HexOhmLabs/ESP-Siesta-Clock-with-Matrix-Display/README.md

# ESP Siesta Clock with Matrix Display

**A clever, super-dark clock that respects your sleep.**

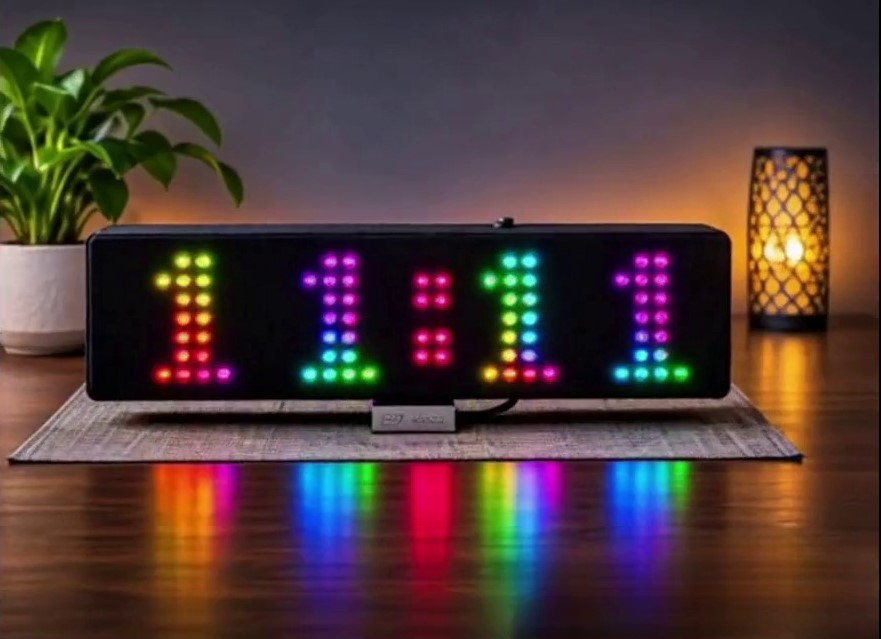
[picture p1: media/ESP_Siesta_Clock_Hero_624.jpg]
ESP Siesta Clock


**2026 by HexOhm**

## Final firmware

`Siesta_WiFi_Clock_HOLIDAYS_WEEKENDS_ANIMATED_FINAL.ino`

- Lines: **8,210**
- Bytes: **182,412**
- SHA-256: `8f3d867dc6df555c29daf55e5889b521067dd3d46866f3558864752d70b486a9`

## Color modes

Mono, Solid Color, Colorful, Funny, **Animated**, Dynamic.

Animated is placed immediately after Funny. It keeps the Funny per-pixel idea but continuously and smoothly transitions each lit LED toward independently changing colors, without a short repeating loop. Existing clock priorities and functions remain unchanged.

## Included documentation

- User Manual - English
- Εγχειρίδιο Χρήσης - Ελληνικά
- Technical Reference - English
- Τεχνική Αναφορά - Ελληνικά
- Instructables publication draft
- Canonical KiCad schematic + PNG
- `IR_Remote_Tester.ino` helper utility for identifying alternative NEC remotes

## Demonstration videos

Two short vertical promo/demo videos are included. They show the clock first in a colorful bedside presentation and then the room progressively darkening as the person goes to bed, matching the project's sleep-first theme.

- `media/ESP_Siesta_Clock_Sleep_Promo_FullHD.mp4` - 1080 x 1920, 6.5 s
- `media/ESP_Siesta_Clock_Sleep_Promo_720p.mp4` - 720 x 1280, 6.5 s
- `media/ESP_Siesta_Clock_Sleep_Promo_Preview.jpg` - preview frame

The two MP4 files contain the same sequence at different resolutions.

## As-is

This project is provided as-is.
Also in Instructables at https://www.instructables.com/Esp8266-Siesta-Clock-With-Matrix-Display/

**2026 by HexOhm**
