HexOhmLabs/ESP-Siesta-Clock-with-Matrix-Display/media/1000013960.jpg

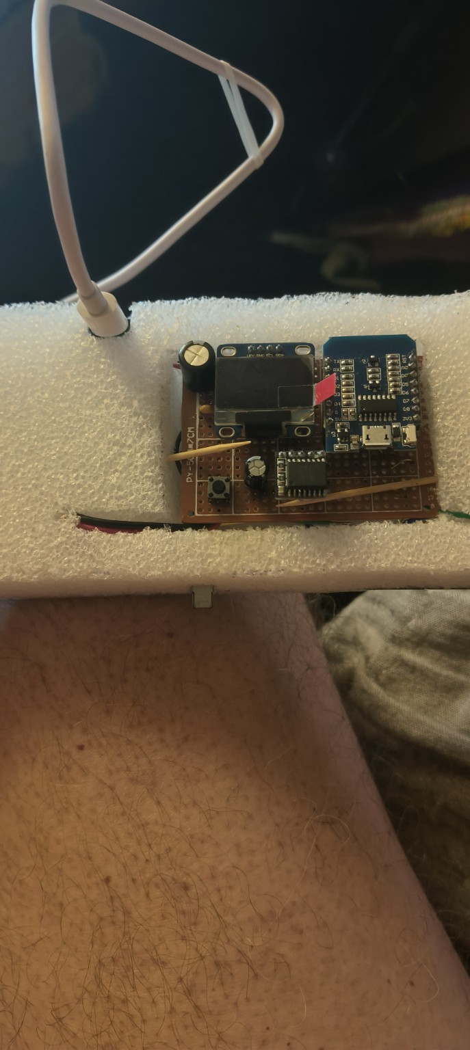
media/1000013960.jpg
