HexOhmLabs/ESP-Siesta-Clock-with-Matrix-Display/media/1000013961.jpg

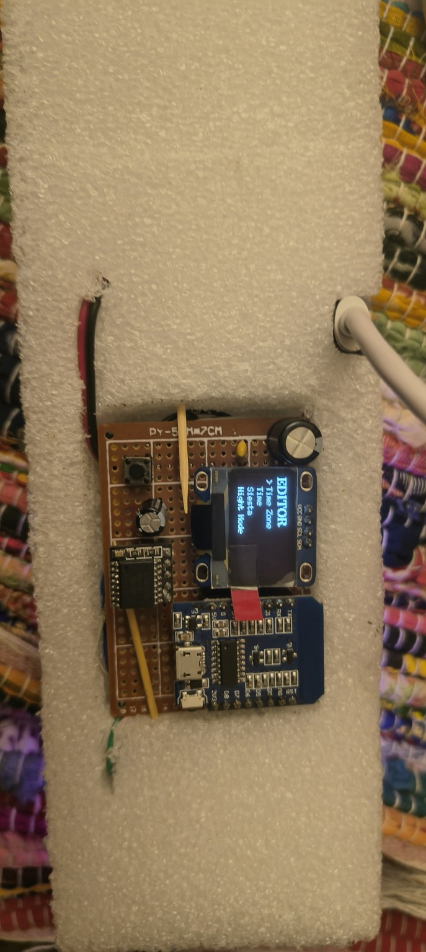
media/1000013961.jpg
