HexOhmLabs/ESP-Siesta-Clock-with-Matrix-Display/media/1000013967.jpg

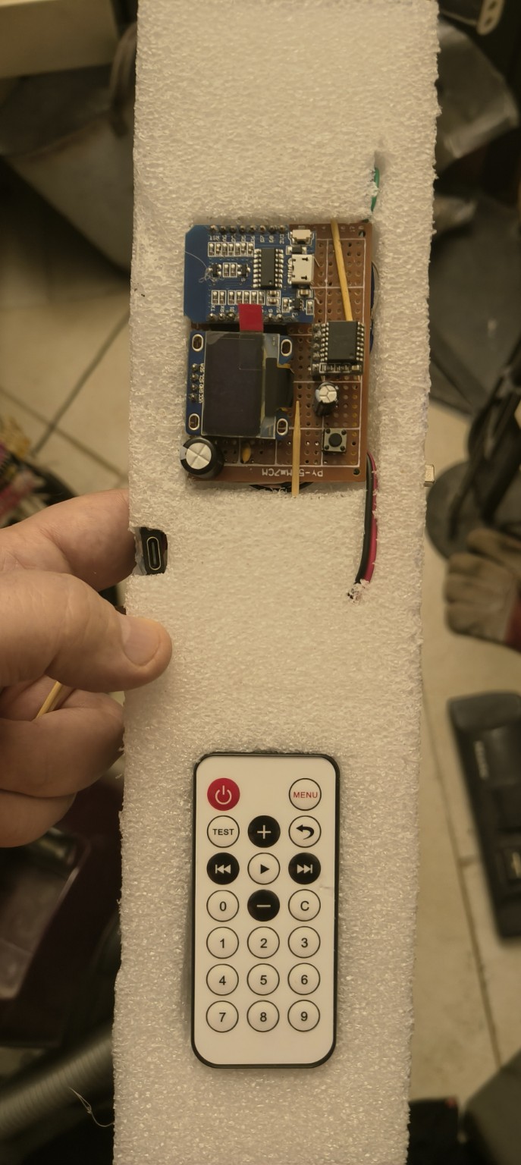
media/1000013967.jpg
