HexOhmLabs/ESP-Siesta-Clock-with-Matrix-Display/media/1000014059.jpg

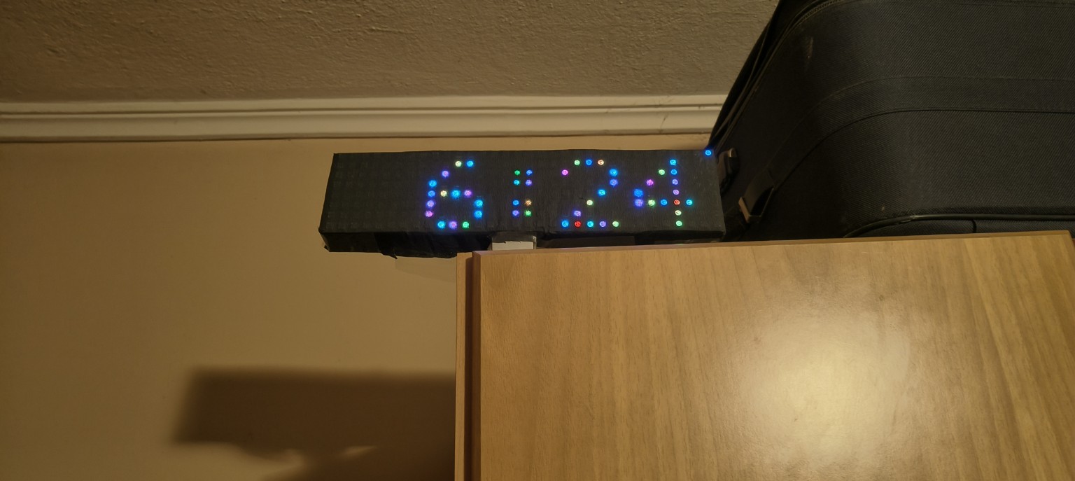
media/1000014059.jpg
