HexOhmLabs/ESP-Siesta-Clock-with-Matrix-Display/media/1000014109.jpg

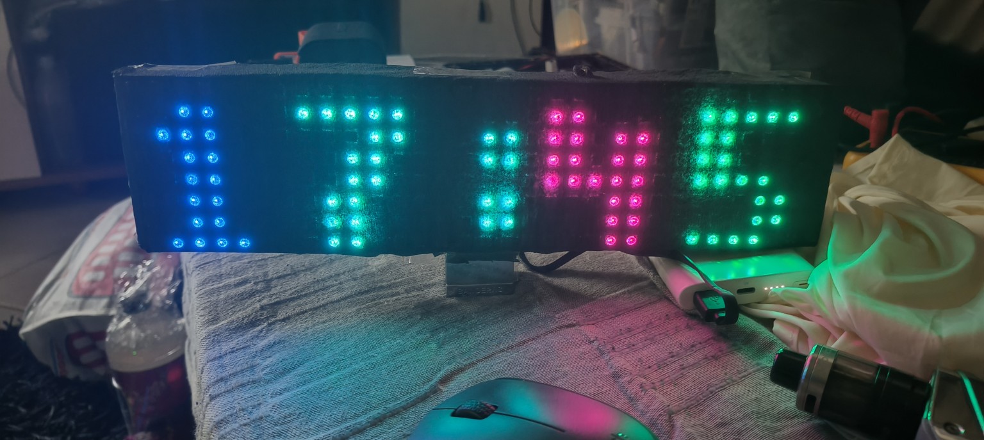
media/1000014109.jpg
