HexOhmLabs/ESP-Siesta-Clock-with-Matrix-Display/media/1000014123.jpg

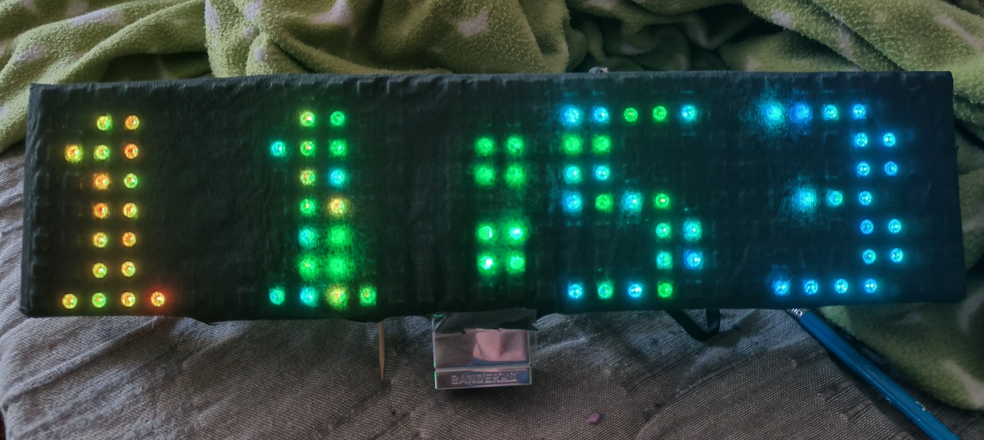
media/1000014123.jpg
