HexOhmLabs/ESP-Siesta-Clock-with-Matrix-Display/media/1000014222.jpg

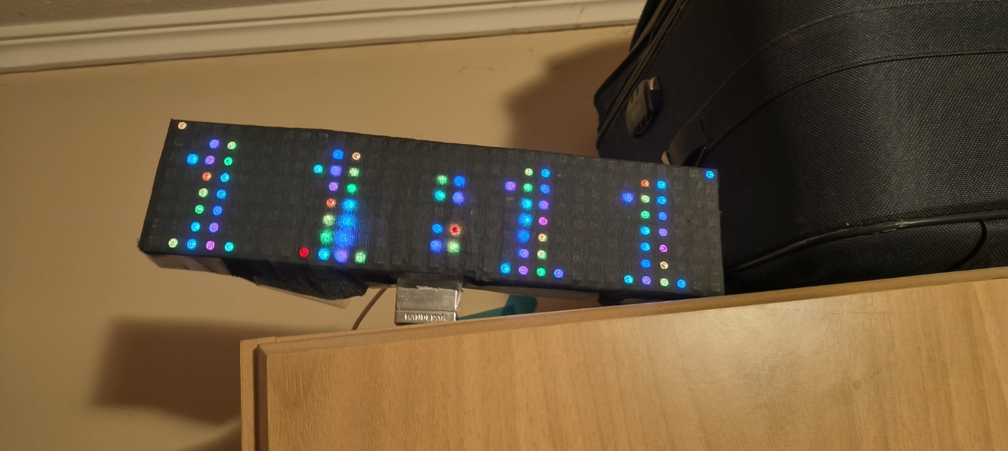
media/1000014222.jpg
