HexOhmLabs/ESP-Siesta-Clock-with-Matrix-Display/media/ESP_Siesta_Clock.png

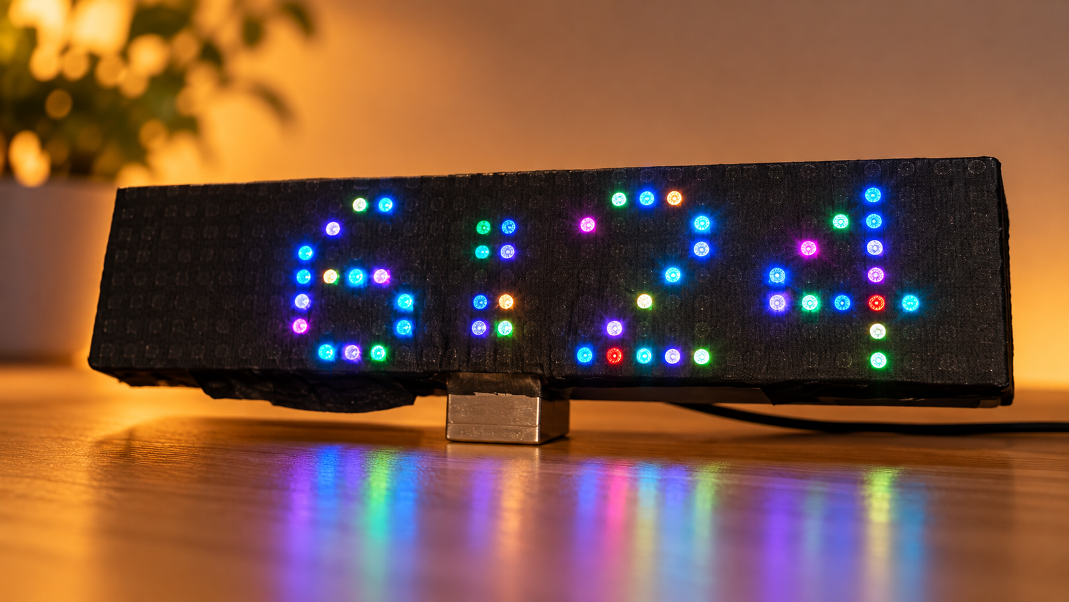
media/ESP_Siesta_Clock.png
