HexOhmLabs/ESP-Siesta-Clock-with-Matrix-Display/media/IMG20260601122547.jpg

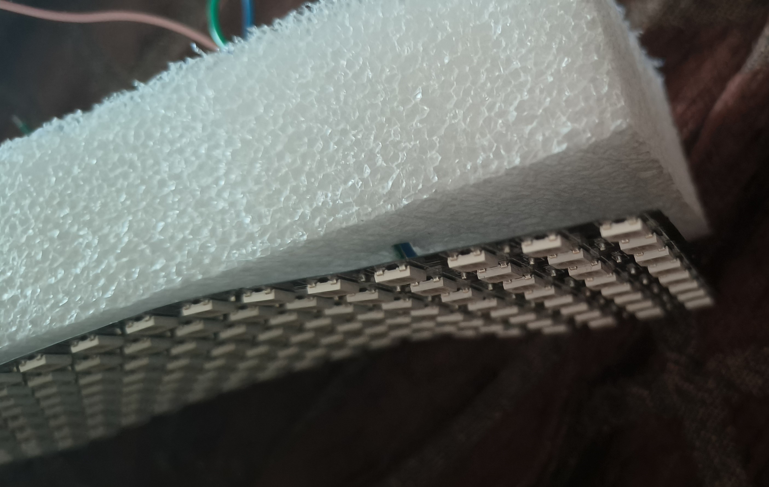
media/IMG20260601122547.jpg
