HexOhmLabs/ESP-Siesta-Clock-with-Matrix-Display/media/IR_Remote_and_Code_Detection.png

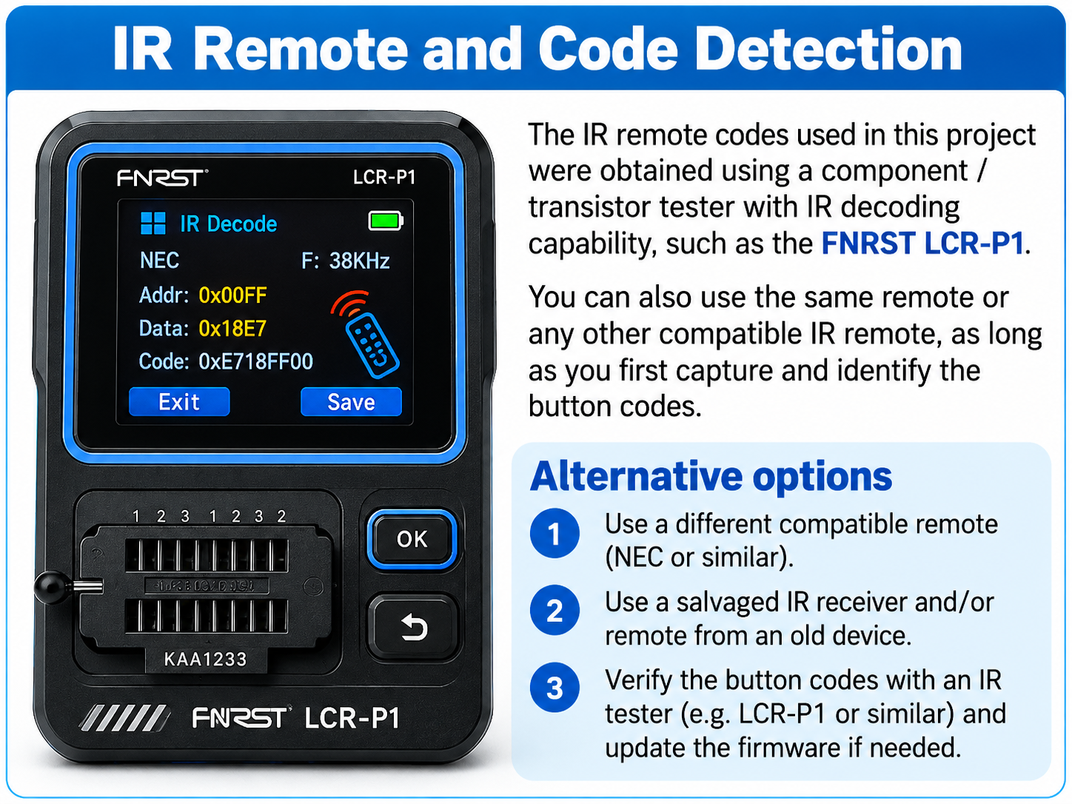
media/IR_Remote_and_Code_Detection.png
