HexOhmLabs/ESP-Siesta-Clock-with-Matrix-Display/hardware/BOM.png

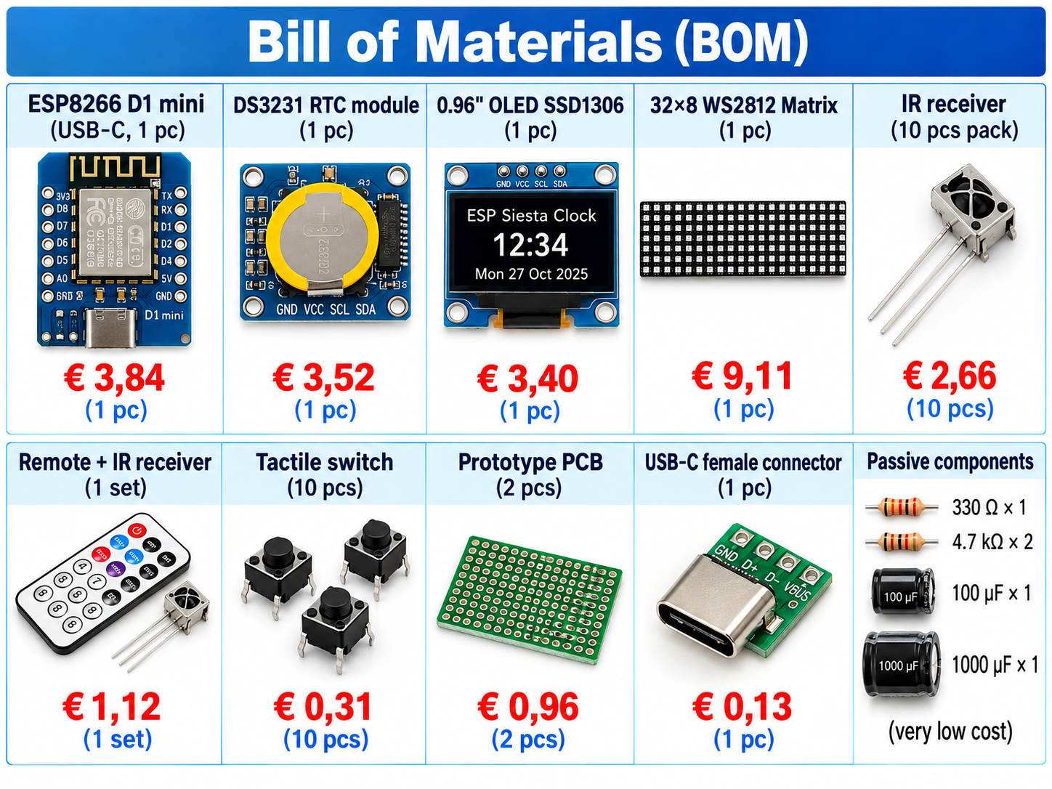
hardware/BOM.png
