HexOhmLabs/ESP-Siesta-Clock-with-Matrix-Display/RELEASE_NOTES.md

# ESP Siesta Clock - Animated Final

2026 by HexOhm

This package is synchronized with the user-tested Animated Final firmware.

## Final firmware identity

- Source: `firmware/ESP_Siesta_Clock_with_Matrix_Display.ino`
- Canonical archived source: `Siesta_WiFi_Clock_HOLIDAYS_WEEKENDS_ANIMATED_FINAL.ino`
- Lines: 8,210
- Bytes: 182,412
- SHA-256: `8f3d867dc6df555c29daf55e5889b521067dd3d46866f3558864752d70b486a9`

## Animated mode

`Animated` is placed immediately after `Funny` in the Multi Color menu. It retains the Funny per-pixel character while each lit LED smoothly transitions toward independently generated colors. The transition is continuous and does not use a short repeating animation loop.

No other clock function or parameter was intentionally changed for this feature.

## Documentation included

- English and Greek User Manuals (DOCX + PDF)
- English and Greek Technical References (DOCX + PDF)
- Instructables article (DOCX + PDF)
- README and build/upload notes
- KiCad schematic, schematic image and BOM
- IR remote tester and code-detection graphic
- Hero image

## Demonstration media

This release also includes two versions of the short sleep-themed vertical demo video:

- `media/ESP_Siesta_Clock_Sleep_Promo_FullHD.mp4` - 1080 x 1920, 6.5 s
- `media/ESP_Siesta_Clock_Sleep_Promo_720p.mp4` - 720 x 1280, 6.5 s

Both videos contain the same sequence; the two resolutions are provided for different publishing needs.
