HexOhmLabs/ESP-Siesta-Clock-with-Matrix-Display/hardware/clock.kicad_sch

## KiCad design hardware/clock.kicad_sch (2026-11-11)

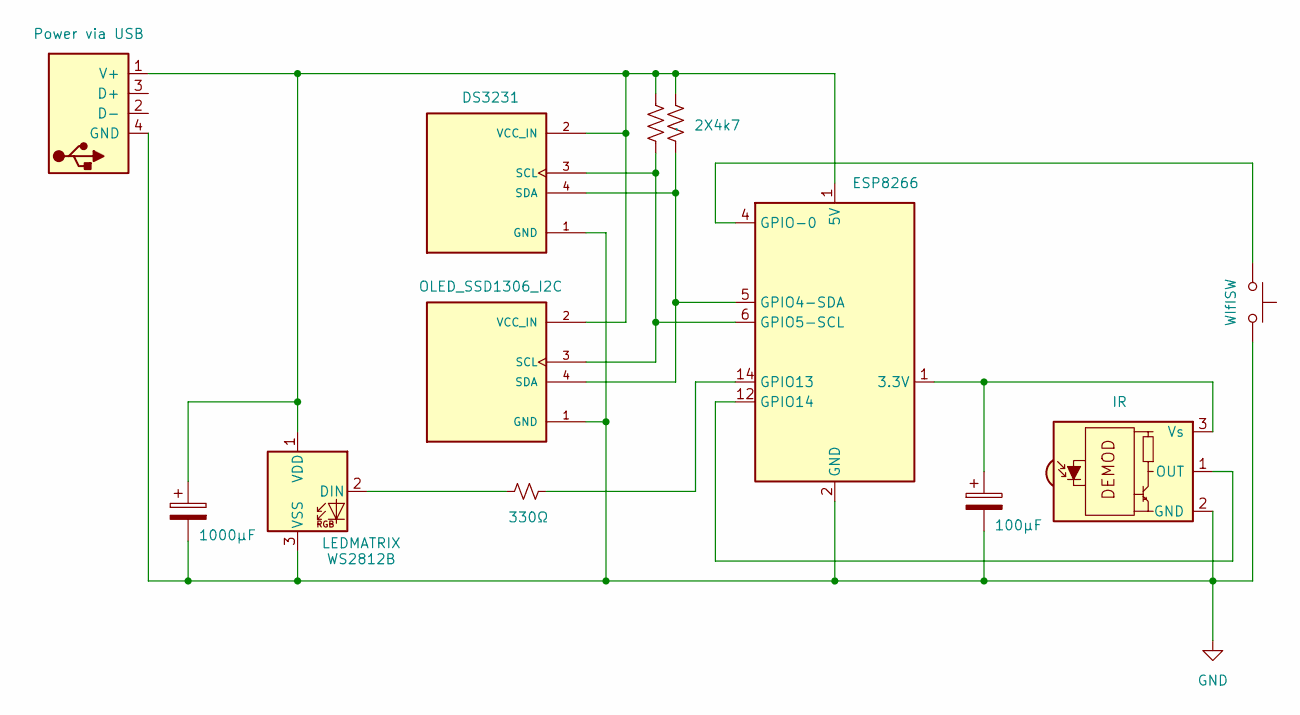
[picture p16: schematic clock.kicad_sch]

Parts:
2X4k7, .: R_US
100μF, 1000μF: C_Polarized
330Ω: R_Small_US
DS3231: DM-OLED096-636; MODULE_DM-OLED096-636; PARTREV 2018-09-10
J1: Power via USB
LEDMATRIX: WS2812B; LED_WS2812B_PLCC4_5.0x5.0mm_P3.2mm
OLED_SSD1306_I2C: DM-OLED096-636; MODULE_DM-OLED096-636; PARTREV 2018-09-10
U2: ESP8266; Olimex_MOD-WIFI-ESP8266-DEV
U3: IR; Vishay_MOLD-3Pin
WIfISW: SW_MEC_5G

Connections:
GND: 100μF.2, 1000μF.2, DS3231.1 (GND), J1.4 (GND), LEDMATRIX.3 (VSS), OLED_SSD1306_I2C.1 (GND), U2.2 (GND), U3.2 (GND), WIfISW.3 (B), WIfISW.4 (B)
unnamed: 2X4k7.2, DS3231.4 (SDA), OLED_SSD1306_I2C.4 (SDA), U2.5 (GPIO4-SDA)
unnamed: 100μF.1, U2.1 (5V), U3.3 (Vs)
unnamed: 330Ω.1, U2.14 (GPIO13)
unnamed: 330Ω.2, LEDMATRIX.2 (DIN)
unnamed: 2X4k7.1, 1000μF.1, ..1, DS3231.2 (VCC_IN), J1.1 (V+), LEDMATRIX.1 (VDD), OLED_SSD1306_I2C.2 (VCC_IN), U2.1 (5V)
unnamed: ..2, DS3231.3 (SCL), OLED_SSD1306_I2C.3 (SCL), U2.6 (GPIO5-SCL)
unnamed: U2.4 (GPIO-0), WIfISW.1 (A), WIfISW.2 (A)
unnamed: U2.12 (GPIO14), U3.1 (OUT)
